Nobcha/R909-SDR/R909-DSP_front.jpg

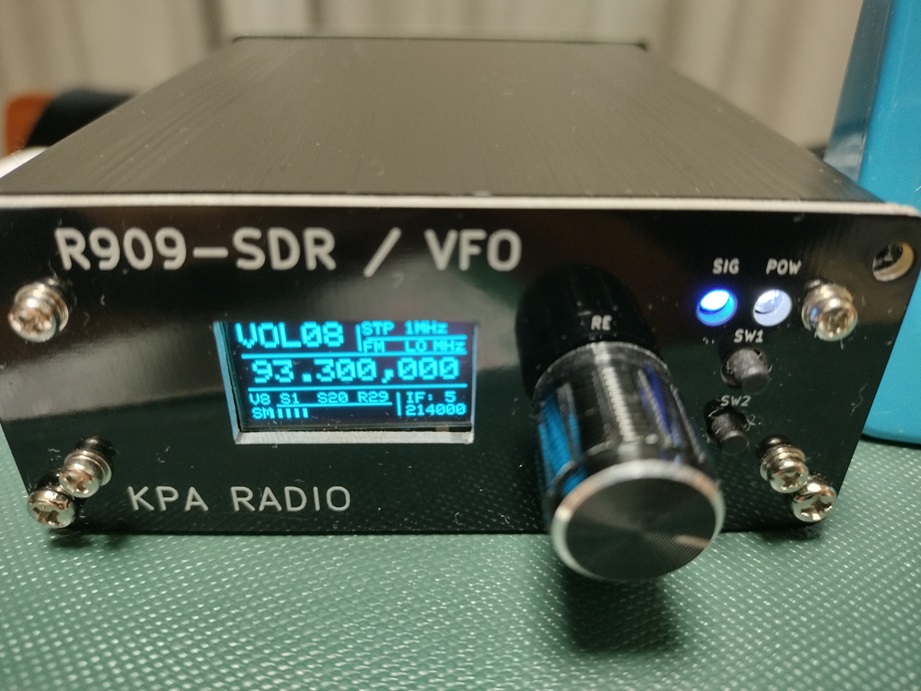
R909-DSP_front.jpg
