Nobcha/R909-SDR/dsp1_vs_dsp4_1.jpg

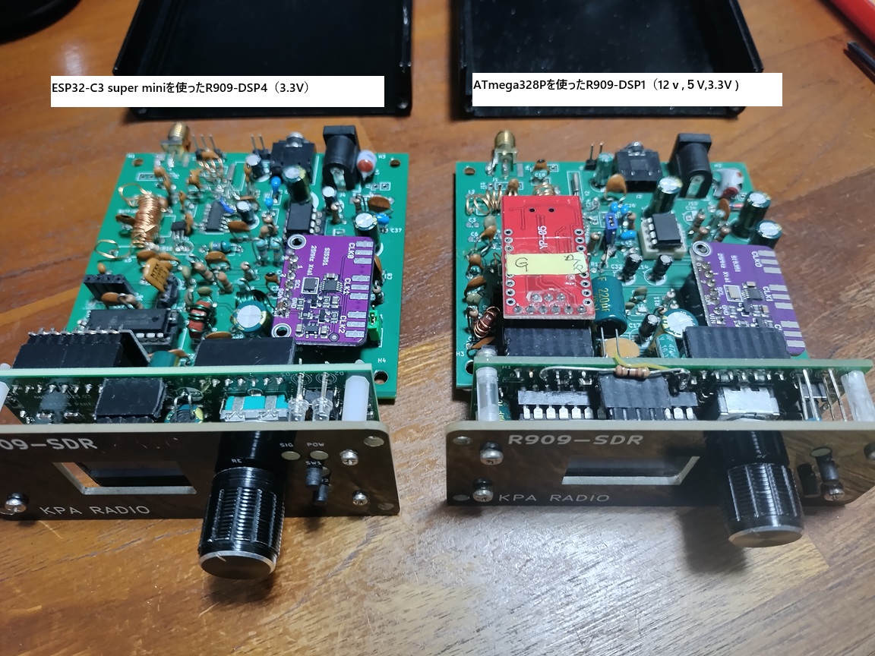
dsp1_vs_dsp4_1.jpg
