Nobcha/R909-SDR/R909_20240408JA_情報一覧.docx

R909-SDR current data warehouse 2023.12.27/2024.01.14/2024.01.17 | | | 2024.04.08
WEB DIRECTRY: https://github.com/Nobcha/R909-SDR/
プリントパターン、部品、スケッチなどの間違い訂正表 | | errata: errata1221.jpg
R909-DSP-1602 | Data 2023.12.27 | WEB Address | 注記
RF PCB RF部基板関連 | Gerber | 4732_2003_386_W78.kicad_pcb-1.zip | VIA抜けあり
| Block diagram | R909-SDR-1602_BD.jpg | ブロック図
| BOM | 4732_2003_386_BOM.pdf | 部品構成表
| Coils | coils_R909-SDR.pdf | コイル巻き方
| SILK | 4732_2003_386_RF_silk.pdf | SILK
| Schematic | 4732_2003_386_RF_scm.pdf. | 回路図
Debug Panel PCB LCD1602Aを使ったパネル部基板関連 | Gerber data | 5531_debugPanel.zip | Gerber (http://chitose6thplant.web.fc2.com/R909/5531_debugPanel.zip)データ
| Block diagram | R909-SDR-1602_BD.jpg | ブロック図
| PCB A side | 5351_pro_at_LCD_A.pdf | A side
| PCB B side | 5351_pro_at_LCD_B.pdf | B side
| BOM | 5531_debug_panel_bom.pdf | 部品表
| PCB silk | 5351_pro_at_LCD_SILK.pdf | SILK (http://chitose6thplant.web.fc2.com/R909/5351_pro_at_LCD_SILK.pdf)
| schematic | 5531_debug_panel_scm.pdf | 回路図
1602Ａ表示 | Arduino sketch | R909-SDR-1602_test4.ino | Arduino code
操作法に関するデータ | Operation flow chart | R909_op_flow.jpg | 操作処理の流れ
| Operation example video | https://www.youtube.com/watch?v=wb-YdMU-vz0 | YOUTUBE
R９０９-DSP－OLED | Data_NAME@2023.12.27/2024.01.14 | WEB Address | 注記
RF PCB RF部基板関連 | Gerber | 4732_2003_386_W78.kicad_pcb-1.zip | VIA抜けあり
| Block diagram | R909-SDR-1602_BD.jpg | ブロック図
| BOM | 4732_2003_386_BOM.pdf | 部品構成表
| Coils information | coils_R909-SDR.pdf | コイルの作成
| PCB silk | 4732_2003_386_RF_silk.pdf | SILK
| schematic | 4732_2003_386_RF_scm.pdf | 回路図
Panel PCB OLEDを使ったパネル部基板関連 | Gerber | 5531_ATm_20_NORM.kicad_pcb-2 | 基板発注用
| Block diagram | R909-SDR-OLED_BD.jpg | ブロック図
| BOM | R909-SDR-Panel_OLED_bom.pdf | 部品構成表
| PCB silk | panel20_PCB_silk.jpg | SILK
| schematic | R909-SDR-Panel_OLED_scm.pdf | 回路図
ＯＬＥＤ表示のＡｒｄｕｉｎｏスケッチ | R909-SDR-OLED_test2 | R909-SDR-OLED_test2.ino | 20240206版
最新Ａｒｄｕｉｎｏスケッチ | R909-SDR-OLED_test3 | R909-SDR-OLED_test3.ino | 20240210版
操作の仕方 | Operation flow chart | R909-SDR-OLED_flow.jpg | 操作の流れ
| R909-SDR | https://www.youtube.com/watch?v=UpdDh7BYJYI | YOUTUBE
操作法解説 | The air band receiver of R909-SDR-OLED version | https://www.youtube.com/shorts/03Hpvuk5BYI | YOUTUBE
診断スケッチなど | Sketch name | Sketch stored address | 注記
i2c アドレス調べ | i2c_scanner_R909PANEL.ino | i2c_scanner_R909PANEL.zip | ＵＳＢシリアル
Si4732コマンド | SI4735_01_POC_5351.ino | SI4735_01_POC_5351.ino | ＵＳＢシリアル
組立、操作の説明 | R909-DSP 受信機マニュアル | https://github.com/Nobcha/R909-SDR/R909-SDR_manual02_JA.pdf | 作成途中
