Nobcha/R909-SDR/coils_R909-SDR.pdf

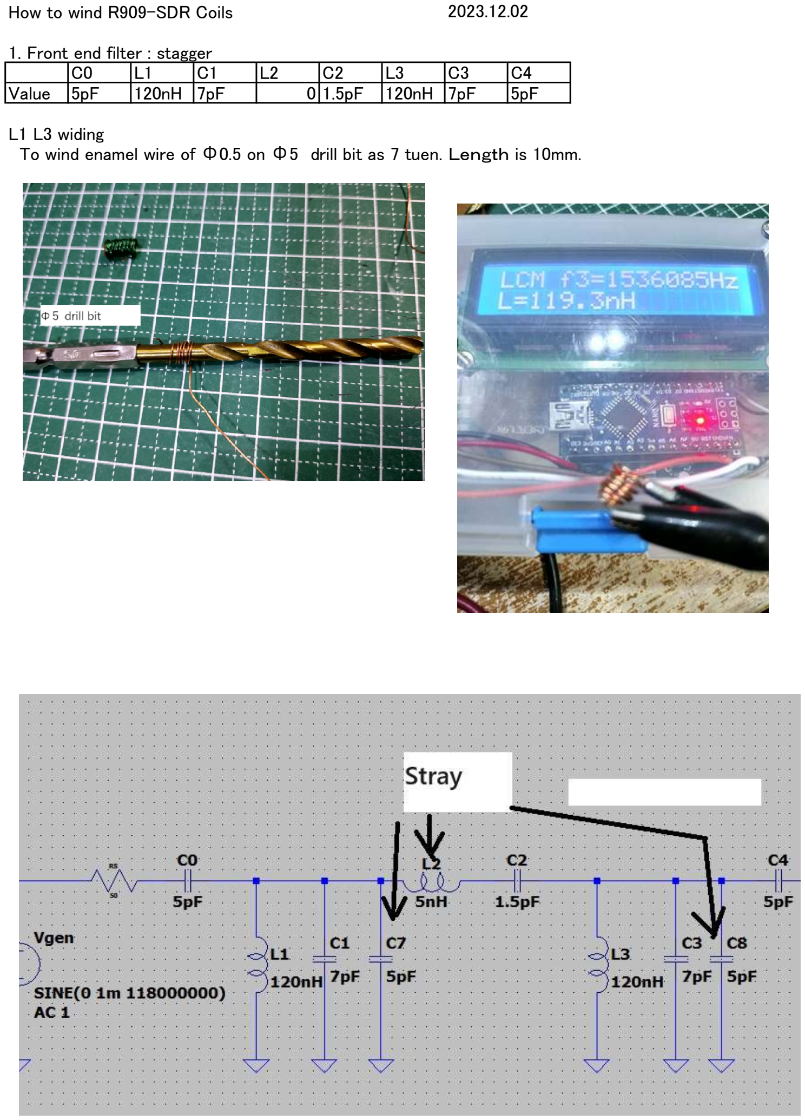
[picture p3: page 1]

How to wind R909-SDR Coils

### 1. Front end filter : stagger

| C0 | L1 | C1 | L2 | C2 | L3 | C3 | C4
Value | 5pF | 120nH | 7pF | 0 | 1.5pF | 120nH | 7pF | 5pF

L1 L3 widing
To wind enamel wire of Φ0.5 on Φ5　drill bit as 7 tuen. Ｌｅｎｇｔｈ is 10mm.

2023.12.02

The actual band path characteristics to monitor by nano VNA. Cener 120MHz ±5MHｚ　-10ｄＢ

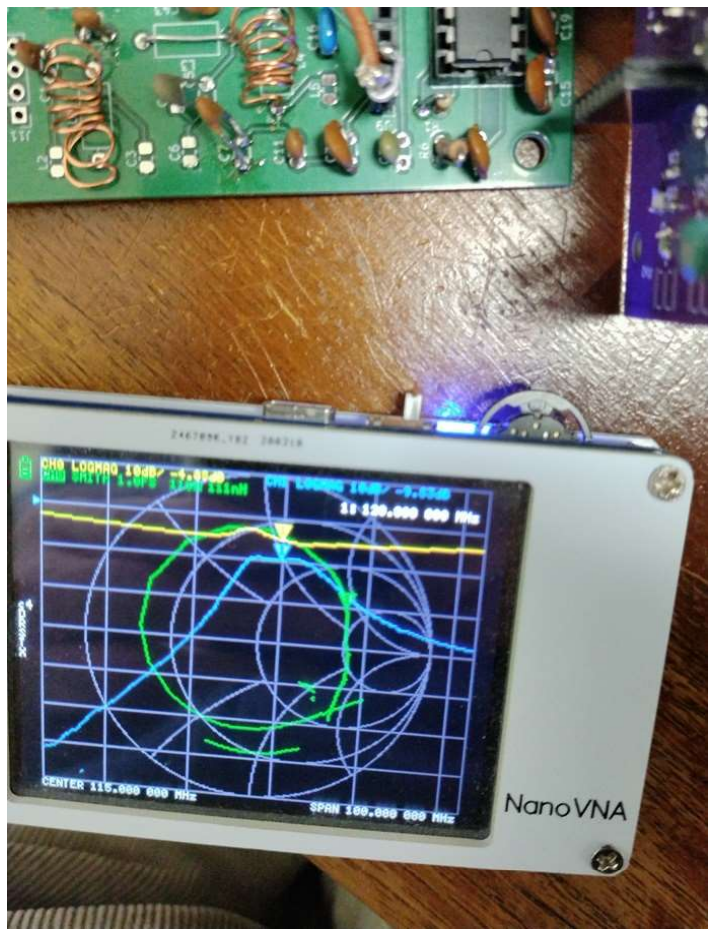
[picture p4: figure]

### 2. TA2003 FM-RF-OUT coil （To be replaced with R1）

Troidal core T25-2(Red) ０.５Φ　Enamel wire 8 turns

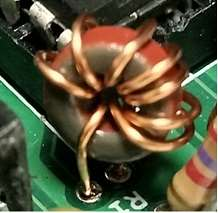
[picture p5: figure]
