Nobcha/R909-SDR/ATmega_ESP32-C3.jpg

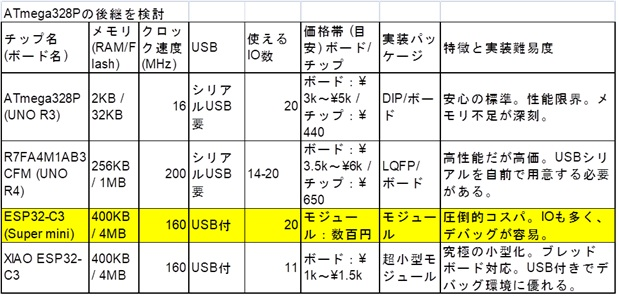
ATmega_ESP32-C3.jpg
