Nobcha/R909-SDR/dsp1_vs_dsp4_4.jpg

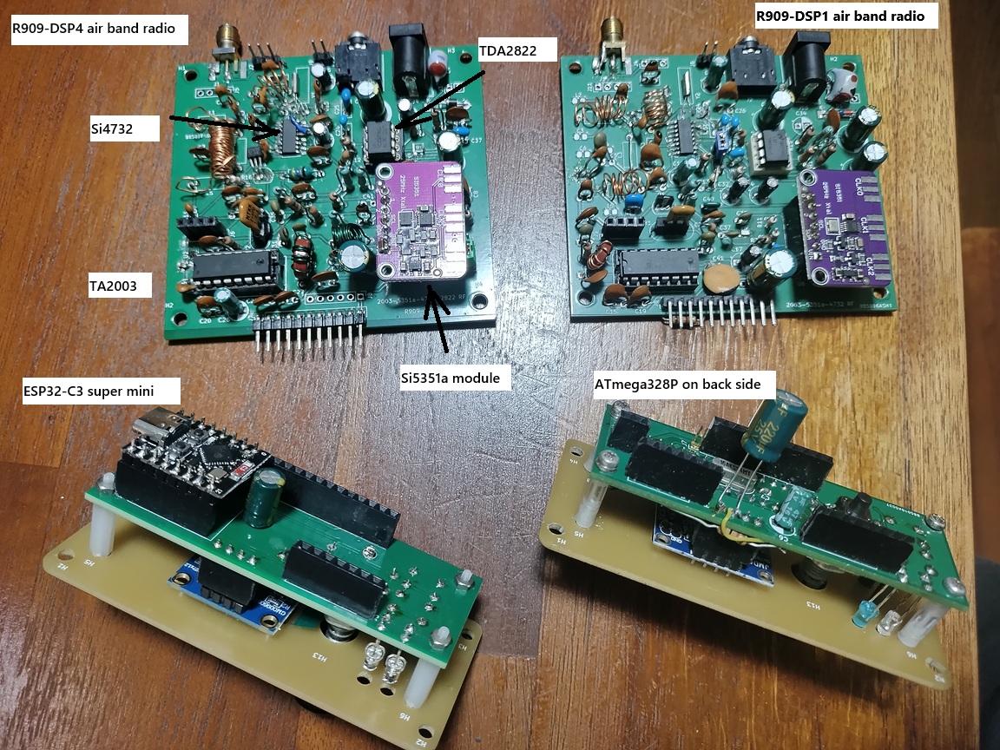
dsp1_vs_dsp4_4.jpg
