Nobcha/R909-SDR/panel20_PCB_silk.jpg

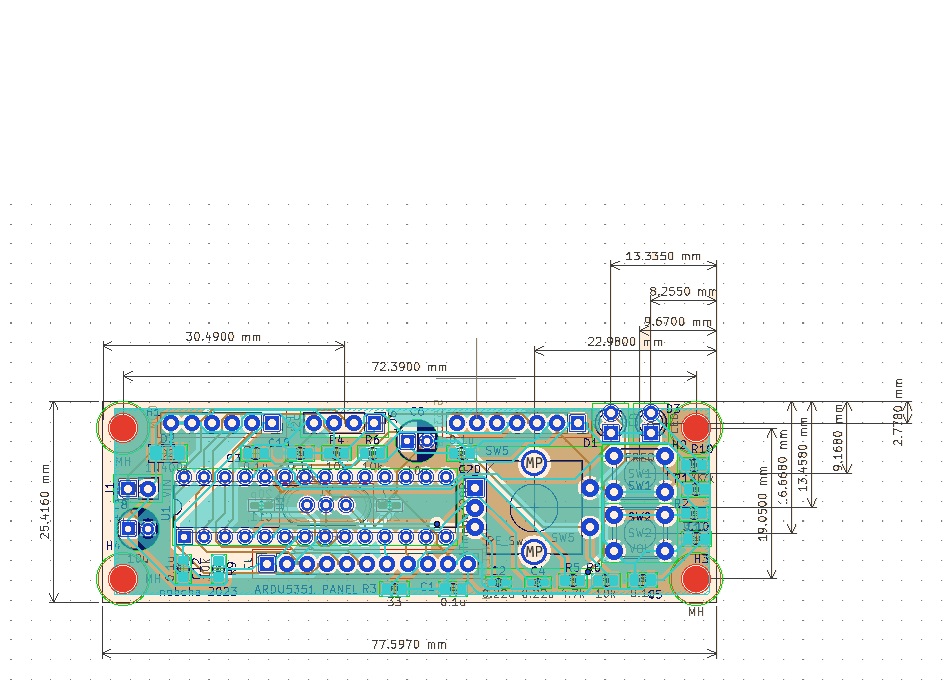
panel20_PCB_silk.jpg
