Nobcha/R909-SDR/r909-DSP_back.jpg

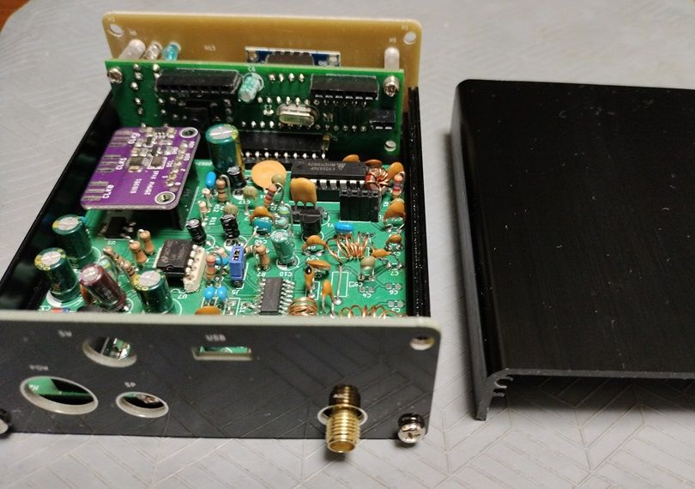
r909-DSP_back.jpg
