Nobcha/R909-SDR/r909-DSP_list_1.jpg

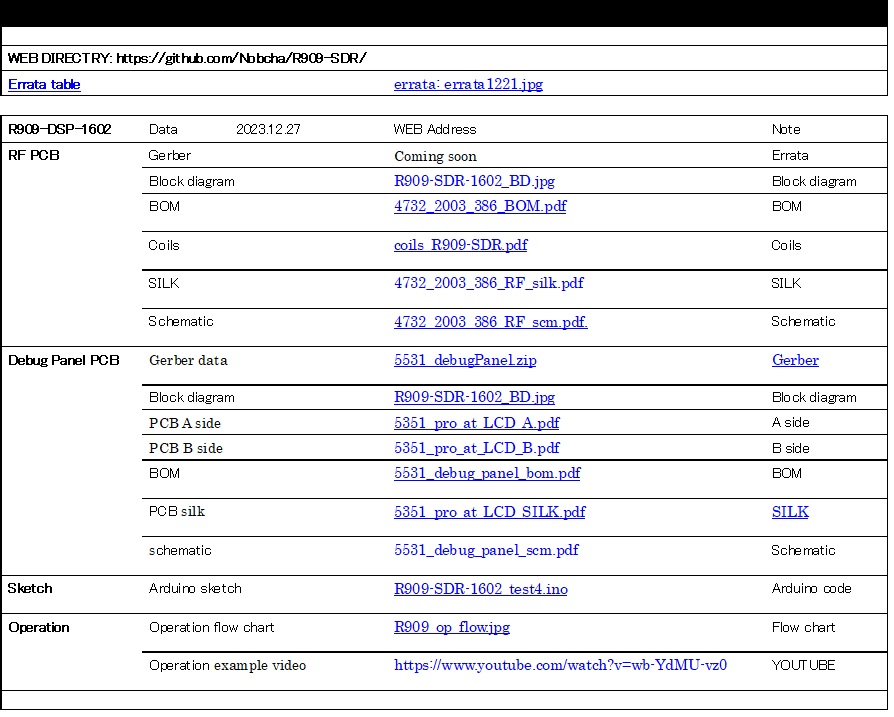
r909-DSP_list_1.jpg
