Nobcha/R909-SDR/r909-DSP_list_2.jpg

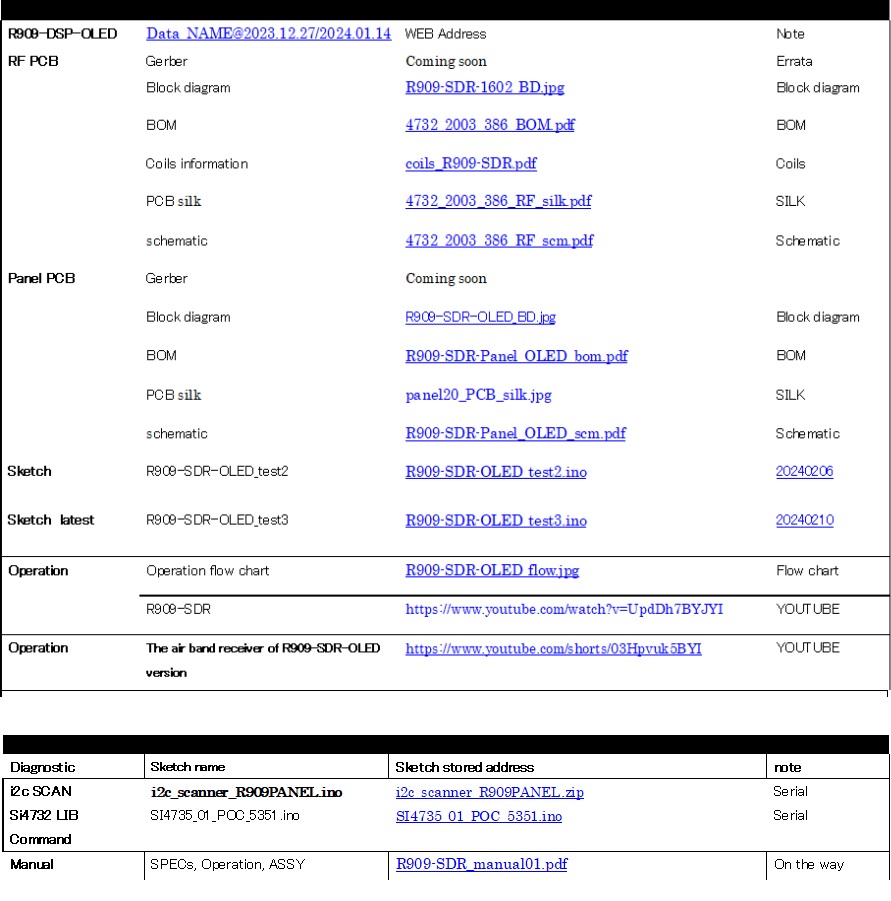
r909-DSP_list_2.jpg
