Nobcha/R909-SDR/R909-SDR-1602_BD.jpg

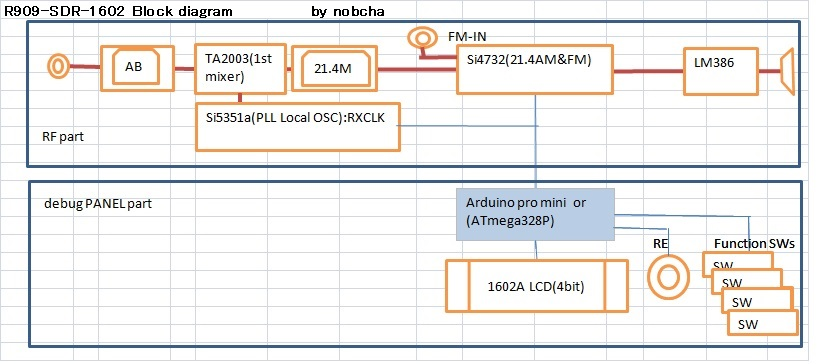
R909-SDR-1602_BD.jpg
