Nobcha/R909-SDR/R909-SDR-OLED_BD.jpg

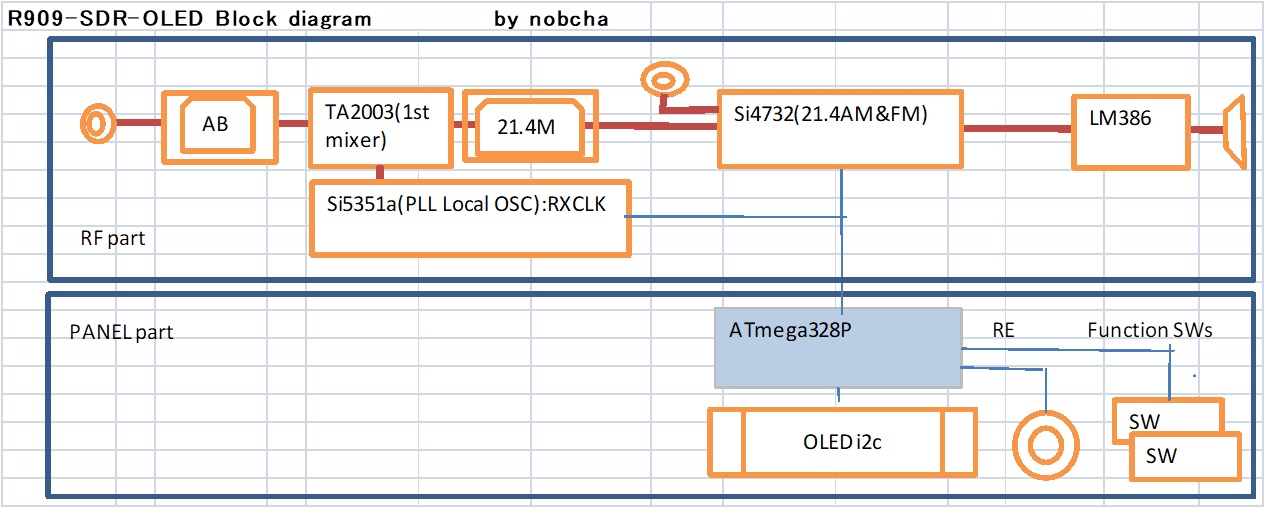
R909-SDR-OLED_BD.jpg
