Nobcha/R909-SDR/R909-SDR-OLED_flow.jpg

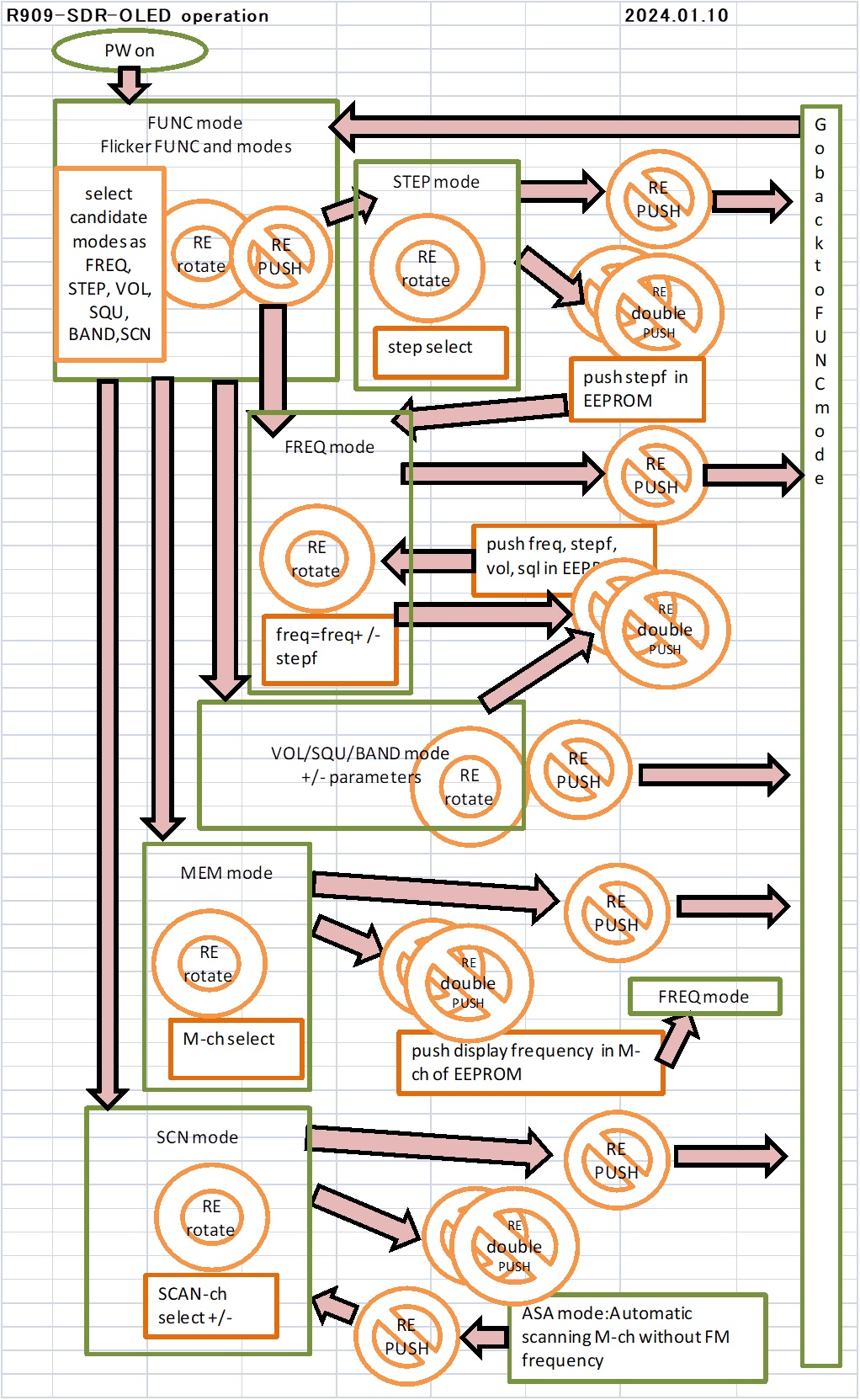
R909-SDR-OLED_flow.jpg
