Nobcha/R909-SDR/R909_op_flow.jpg

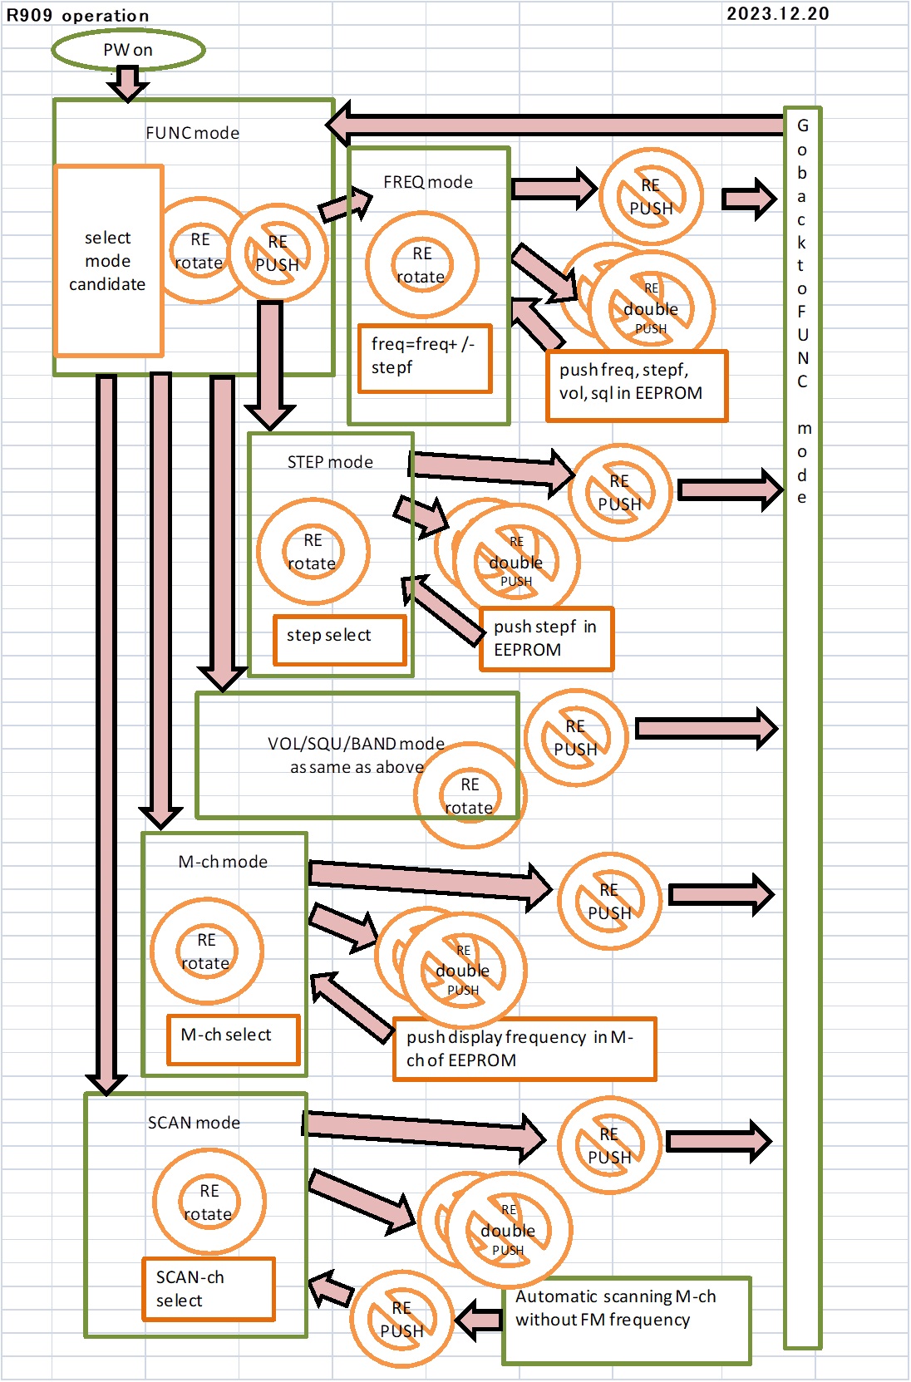
R909_op_flow.jpg
