Nobcha/R909-SDR/R909-SDR_manual02_JA.pdf

## R909-DSP 受信機 (Arduino+Si4732+Si5351a+TA2003+LM386)

## 2024.04.09 tentative by nobcha

### 1. 始めに


-受信機の外観

R909-4732(DSP) は航空無線受信と FM 放送受信ができます。Si5351a, Si4732, TA2003 などのＩＣが 使われています。TA2003とSi5351aをArduino制御し受信周波数を決め、Si4732は中間周波数21.4MHz の受信機として動作させています。ＦＭ放送受信は Si4732 の蓬莱機能を使っています。Arduino の Si4732 制御は PU2CLR のライブラリを利用しました。表示の違いで 2 種類の構成があり、一つは LCD2 行の 1602A を使ったもの、もう一つは OLED(128x64 ビット)を使ったものです。OLED 表示の画面デ ザインは JCR さんの 10khz-to-225mhz-vfo 画面を参考にしました。


-回路ブロック図

この受信機を操作するにはロータリーエンコーダとロータリーエンコーダに付いたプッシュスイッチを 主に使います。

回路基板は Panel 部（CPU、表示、スイッチなど）と RF 部（ラジオや局発モジュールやアンプなど） の二枚から構成されます。Panel 部基板は二種合って 1602A の LCD と OLED 表示のものです。


-受信機のケースの中

### 2. R909-DSP（4732）受信機の詳細

### 2.1 仕様

・受信帯域：航空無線帯域 AM; 118-136MHz, FM 放送帯域 FM: 76-109MHz ・感度：およそ -85dBm
・供給電源：DC+12V、およそ：110 mA
・音声出力：1W max, 2.5 jack
・ケースの大きさ：38h x 88w x 100d、重量：およそ 250grm

### 2.2 回路と基板

回路は RF 部基板と Panel 部基板から構成されます。RF 部には初段フィルター、ミキサーの TA2003、 局発の Si5351a モジュール、LM386 の音声アンプ、電源回路が含まれています。Panel 部には CPU の ATmega328P（Arduino ブートローダ付き、1602A 基板の場合は Arduino pro mini も使えるようになっ

ている)と表示モジュール、スイッチが搭載されています。回路図は次に示す通りです。 Panel 部回路図（1602A）：https://github.com/Nobcha/R909-SDR/5531_debug_panel_scm.pdf Panel 部回路図（OLED）：https://github.com/Nobcha/R909-SDR/R909-SDR-Panel_OLED_scm.pdf RF 部回路図：https://github.com/Nobcha/R909-SDR/4732_2003_386_RF_scm.pdf

### 2.3 操作について

機能操作はロータリーエンコーダとロータリーエンコーダについたプッシュスイッチで行う。3 つの操作 モードがある。機能（FUNC）を選択するモード、各機能の中でパラメータの増減、そして、現状デー タの EEPROM へ記憶させるモードである。機能名称と FUNC が交互表示しているときはロータリーエ ンコーダを回すと機能次々と選択される。プッシュキーを押すと今点滅表示されている機能を選択する。 そうなるとロータリーエンコーダはパラメータの増減に使われる。プッシュキーを一回押すと設定パラ メータを確定し、機能選択モードに戻り、機能名称と FUNC が交互表示される。一回押しでなく二回押 し（ダブルクリック）だと、パラメータを EEPROM に書き込んで元に戻る。操作の流れについては下 記のスローチャート図に示した。
機能は次の 10 種類が用意されている。
・Func: 各機能を選択するモードである。
・FRQ: 周波数を設定するモードで、STP で指定されたステップ周波数単位でインクレメント、デクレ メントする。
・STP: ステップ周波数単位を次から選択。10Hz, 1kHz, 10kHz, 100kHz, 1MHz, and 25kHz ・MEM: 表示されている周波数を記憶するメモリー番号（50 種）を選ぶ。
・SCN: 周波数記憶したメモリー番号（50 種）を選び、呼び出し
・VOL: ボリュームの値を選ぶ
・SQU: スケルチの値を選ぶ
・BAND: AM モードか FM モードを選ぶ
・BAND_W: Si4732 の受信帯域を次から選ぶ 1Hz, 1.5kHz, 2kHz, 4kHz, and 6kHz ・F_COR: Si5351a の基本発振周波数 25MHz を精度補正値を設定


-操作の流れ


・OLED 表示の場合の表示項目説明
-Youtube video

### 2.4 スケッチについて

スケッチにはいくつかの汎用ライブラリや個別ライブラリ、また事例スケッチを引用させていただきま した。1602A 版と OLED 版の二種類のスケッチがあります。
ATmega328P には Arduino UNO のブートローダを書き込んで使っています。
1602A 版 https://github.com/Nobcha/R909-SDR/
OLED 版 https://github.com/Nobcha/R909-SDR/R909-SDR-OLED_test3.ino

There are the diagnostic sketches for testing the hardware, as i2c scanner and USB serial controlling Si4732.
https://github.com/Nobcha/R909-SDR/i2c_scanner_R909PANEL.ziphttps://github.com/Nobcha/R909-SDR/SI4735_01_POC_5351.ino

### 3. 基板の組み立て方

### 3.1 Panel 部 PCB

1602A 版 PCB では Arduino をどちらにするかで部品構成が変わります。

CRD 部品は表面実装を使っていますので、まずはそれらから実装してください。その後背の低い DIP 部 品を実装します。部品は A 面だけでなく B 面にも実装しますのでご注意ください。

https://github.com/Nobcha/R909-SDR/R909-SDR-Panel_OLED_bom.pdfhttps://github.com/Nobcha/R909-SDR/5531_debug_panel_bom.pdf

Arduino や ATmega328P はソケットを使用します。OLED,LED,SW,ロータリーエンコーダはフロント につける意匠パネルとの位置関係があるので注意して取り付けて下さい。 基板への部品実装がうまくいったかどうかは i2c アドレススキャンプログラムを用いて確認ができます。 OLED のアドレス 0x3c が結果表示されるなら組立は成功です。


・部品はんだ付け後調整中

### 3.2 RF 部 PCB

まずは部品リストに従い、部品を用意します。使い方で要否判定しないといけない部品があるのでよく 注意してください。
https://github.com/Nobcha/R909-SDR/R909-SDR-Panel_OLED_bom.pdf

部品実装を手掛ける前にコイルの用意が必要です。ドリルビットなどを利用し、エナメル線で空芯コイ ルを巻きます。トロイダルコイルも必要です。
https://github.com/Nobcha/R909-SDR/coils_R909-SDR.pdf

こちらの基板もまずは表面実装部品を取り付けます。Si4732 などの IC は周りに何もない第一歩にはん だ付けします。


表面部品実装後、背の低い部品から DIP 部品やピンヘッダコネクタをはんだ付けします。

組立がうまくいったかは、Panel 部 PCB と同じく i2c アドレススキャンプログラムを用いて確認ができ ます。Si4732 のアドレス 0x11 や Si5351a のアドレス 0x60 が結果表示されるなら組立は成功です。

### 3.3 調整

コイルのパラメータ確認や、初段帯域フィルタの特性調整には nano VNA とか LC メーターがあると便 利です。.
また、動作確認には航空無線帯域内の微弱信号が用意できるとよいと思います。水晶発振器の高調波 (20MHz 台近辺の水晶なら 6 倍波ぐらいです)が使えます。空港の近辺なら、ATIS 受信が便利です。tiny SA ultra があれば、1ｄＢステップで変調信号付き該当周波数も簡単設定できる信号発生器が付いてい ますので、あると便利です。Y

### 3. 基板をケースに入れる

38x88x100 アルミダイキャストケースにＲＦ基板をスライド挿入し、前面アルミ板に Panel 基板を取り 付けます。
アルミ板加工が大変なので、替わりにプリント基板で全後面パネルを設計検討中です。

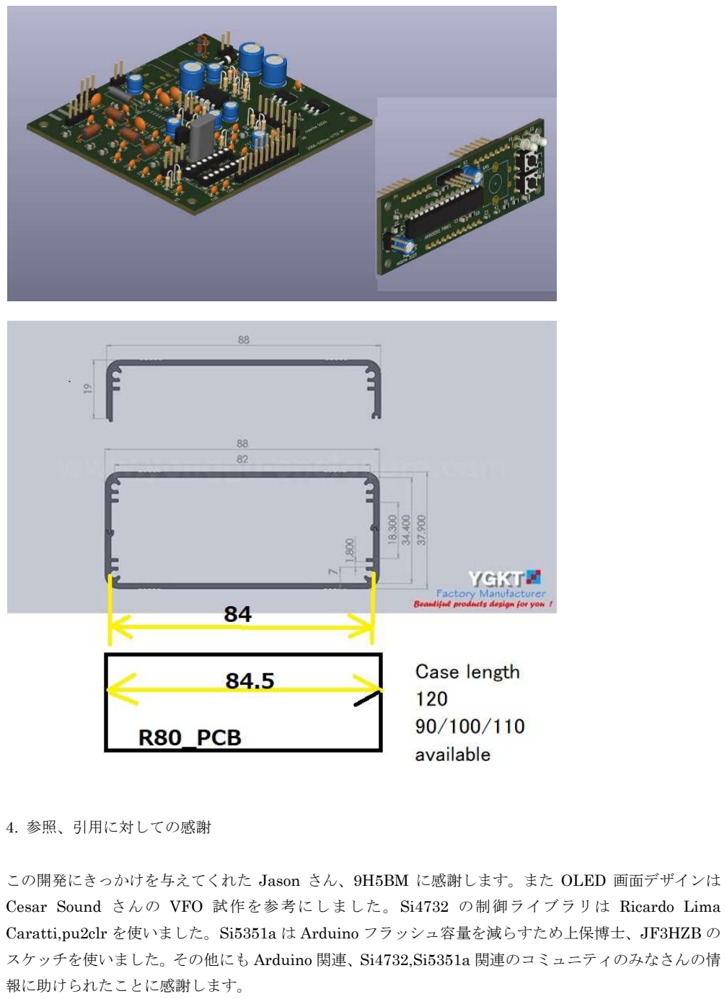
[picture p35: page 8]

### 4. 参照、引用に対しての感謝

この開発にきっかけを与えてくれた Jason さん、9H5BM に感謝します。また OLED 画面デザインは Cesar Sound さんの VFO 試作を参考にしました。Si4732 の制御ライブラリは Ricardo Lima Caratti,pu2clr を使いました。Si5351a は Arduino フラッシュ容量を減らすため上保博士、JF3HZB の スケッチを使いました。その他にも Arduino 関連、Si4732,Si5351a 関連のコミュニティのみなさんの情 報に助けられたことに感謝します。

Jason kits,9H5BM:https://www.facebook.com/profile.php?id=100012257914763
Ricardo Lima Caratti,pu2clr:https://github.com/pu2clr
上保 徹志 (Tetsuji Uebo),JF3HZB:https://tj-lab.org/2017/03/13/si5351/CesarSound:https://www.hackster.io/CesarSound/10khz-to-225mhz-vfo-rf-generator-with-si5351-ver sion-2-bfa619

©nobcha JA3KPA
