Nobcha/R909-SDR/errata1221.jpg

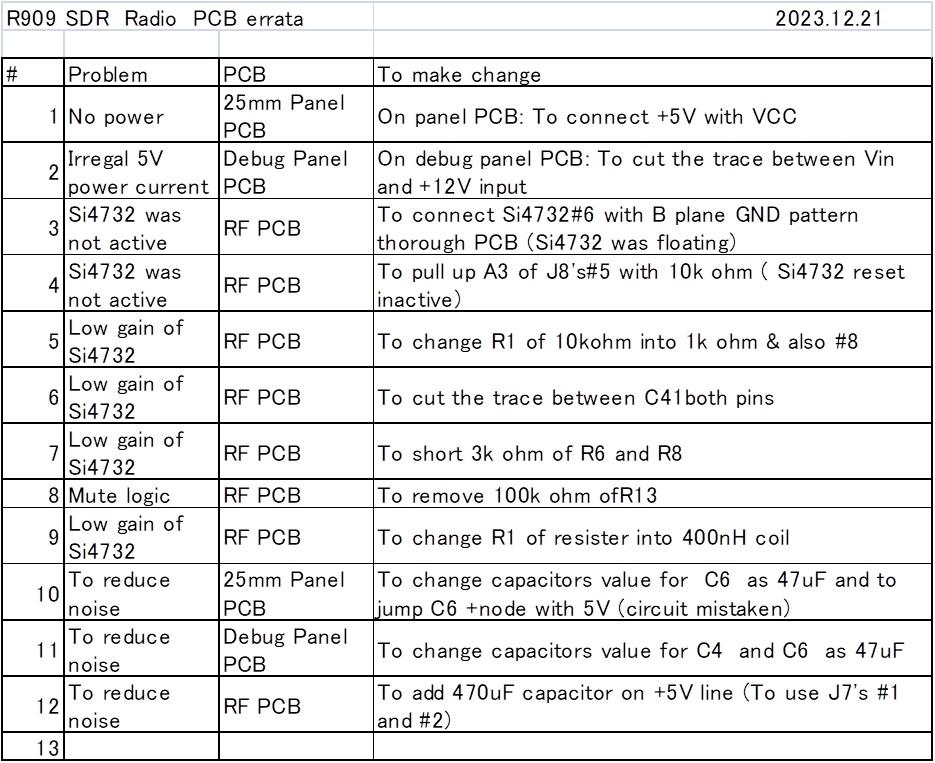
errata1221.jpg
