Nobcha/R909-SDR/errata240419.jpg

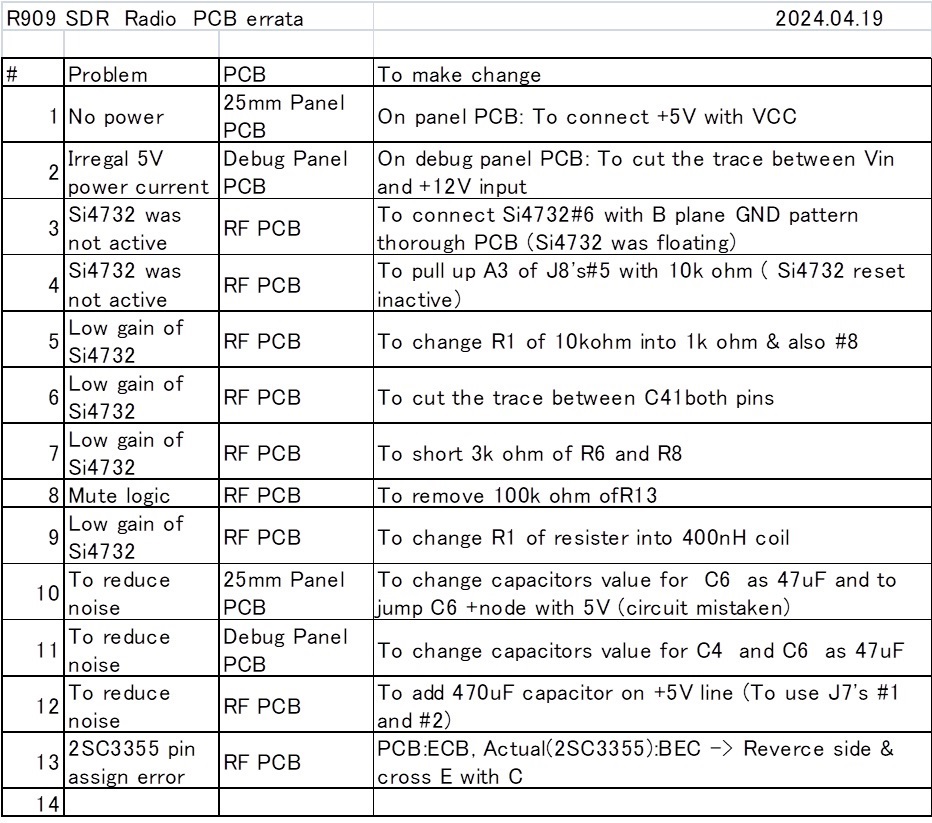
errata240419.jpg
