Nobcha/R909-SDR/errata240624.jpg

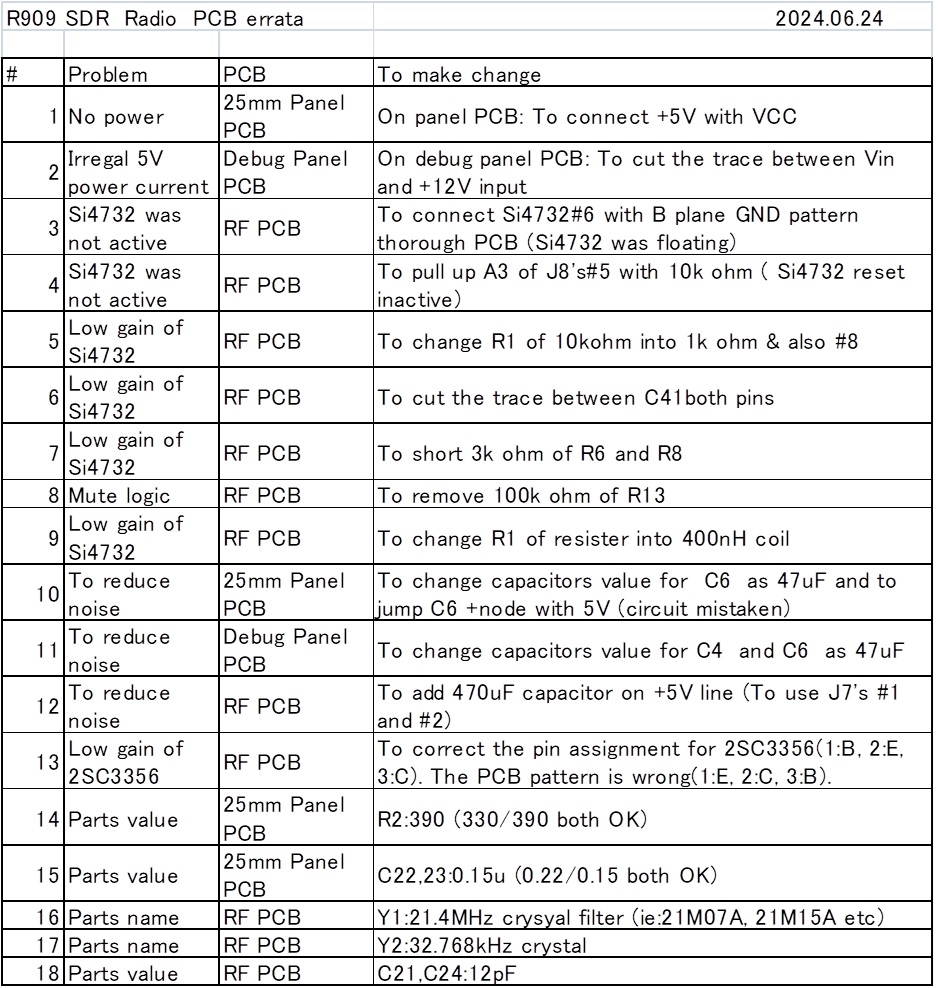
errata240624.jpg
