Nobcha/R909-SDR/5531_debug_panel_scm.pdf

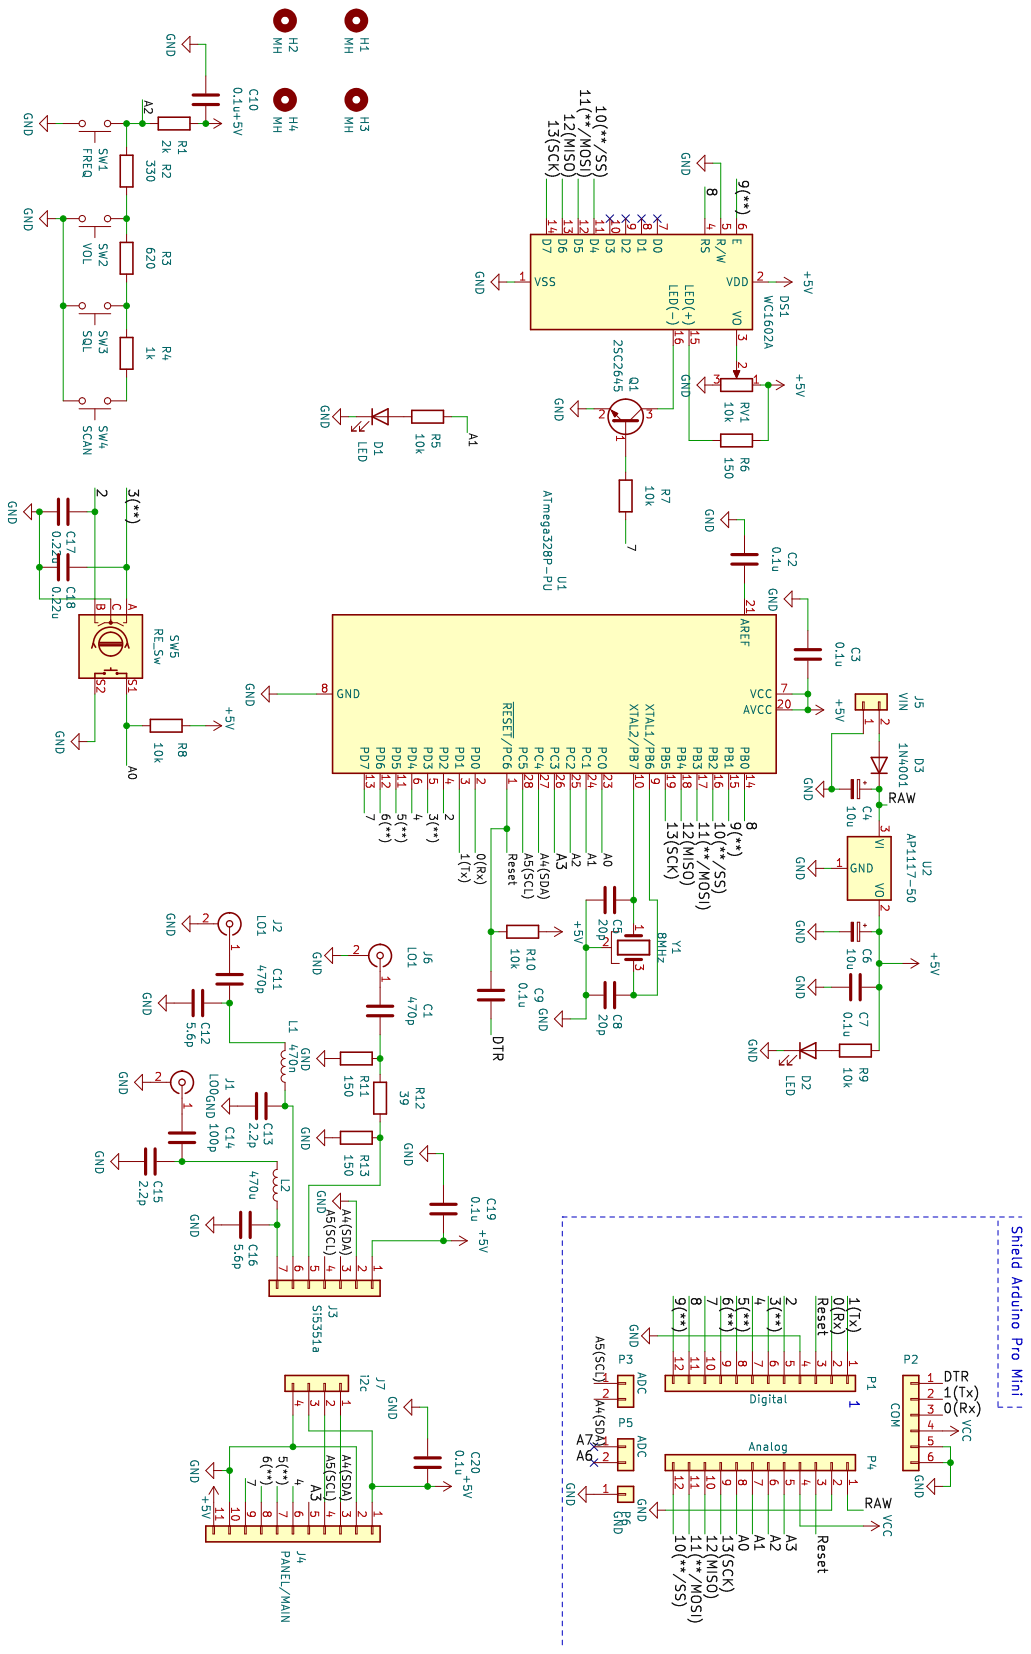
[picture p43: page 1]
