Nobcha/R909-SDR/R909-SDR-Panel_OLED_scm.pdf

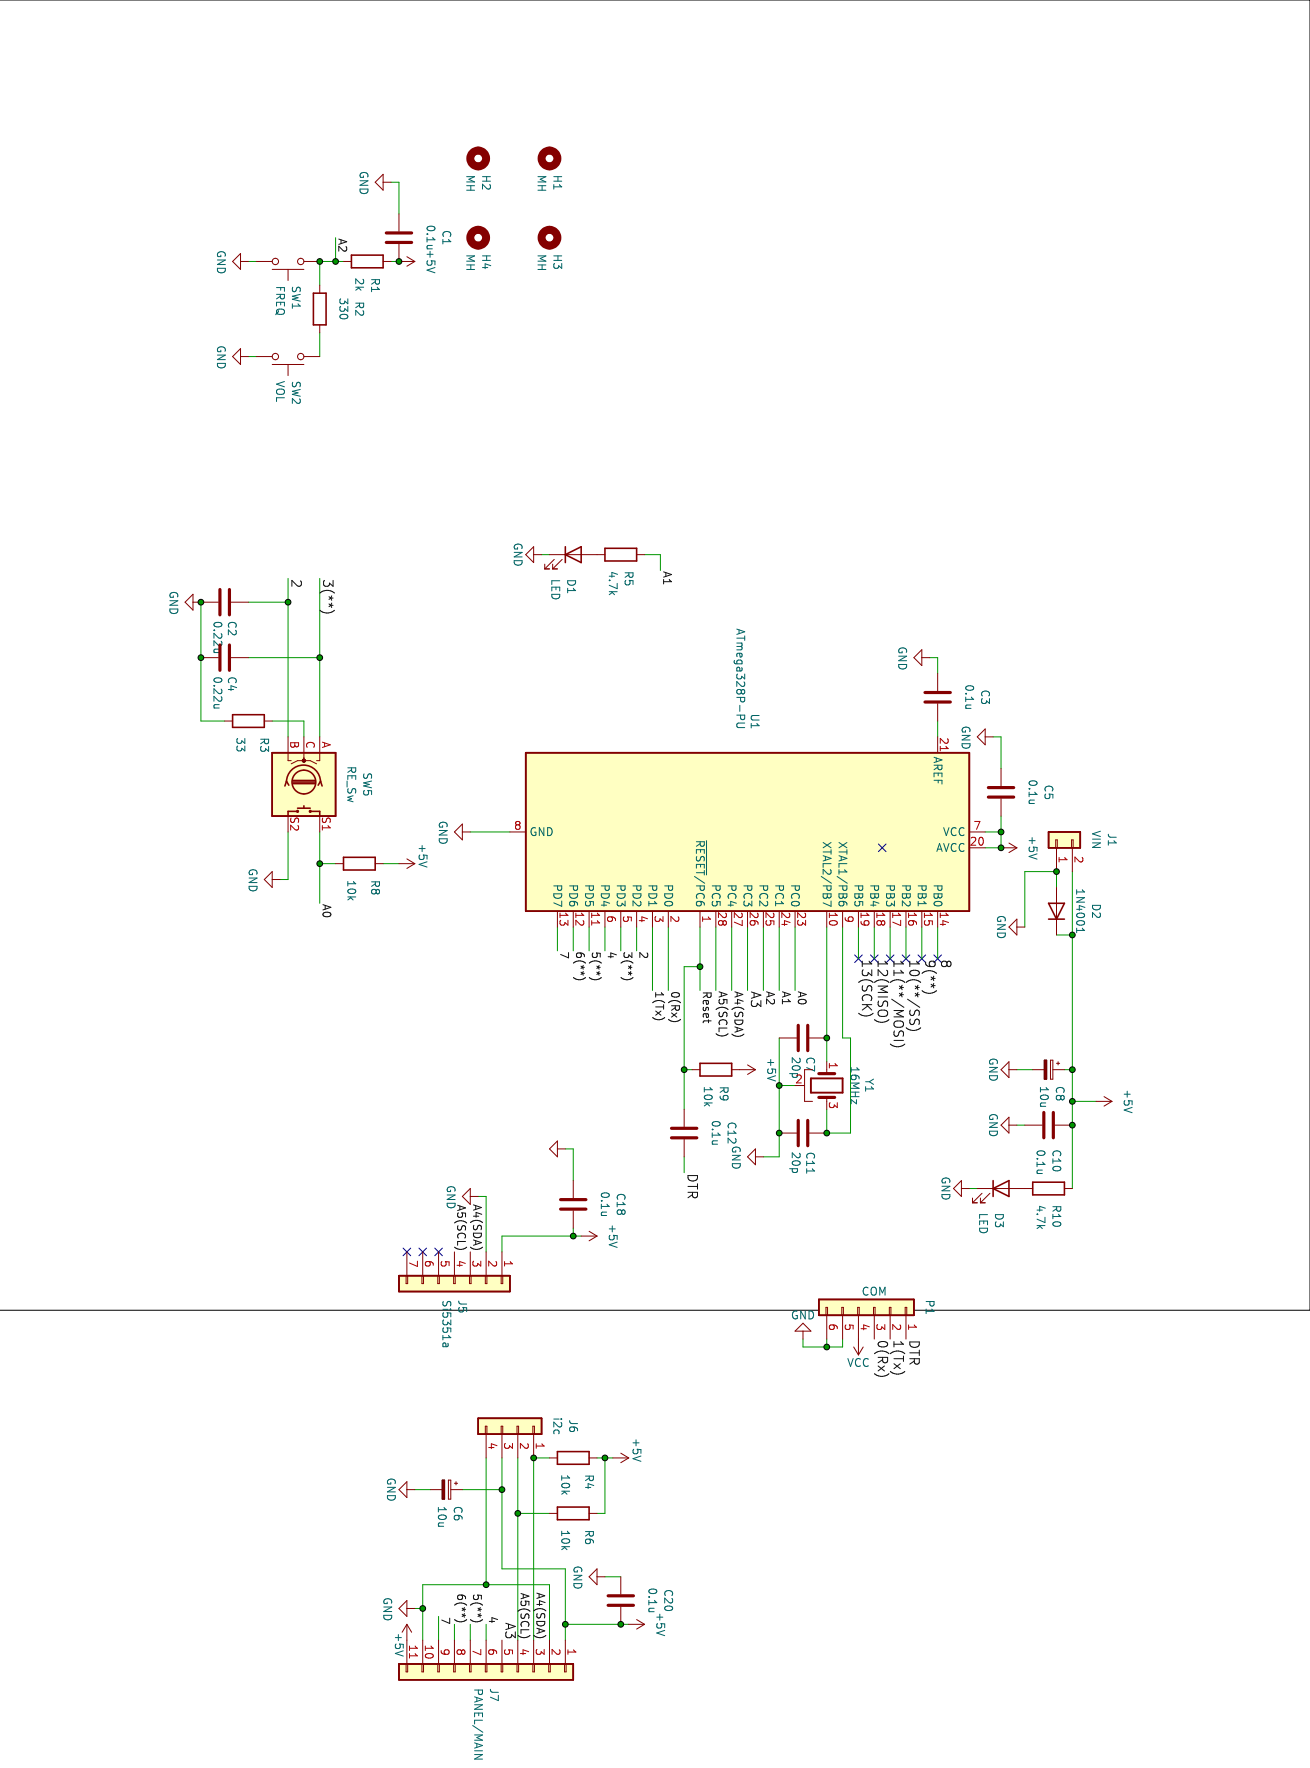
[picture p44: page 1]
