Nobcha/R909-SDR/RF_scm.pdf

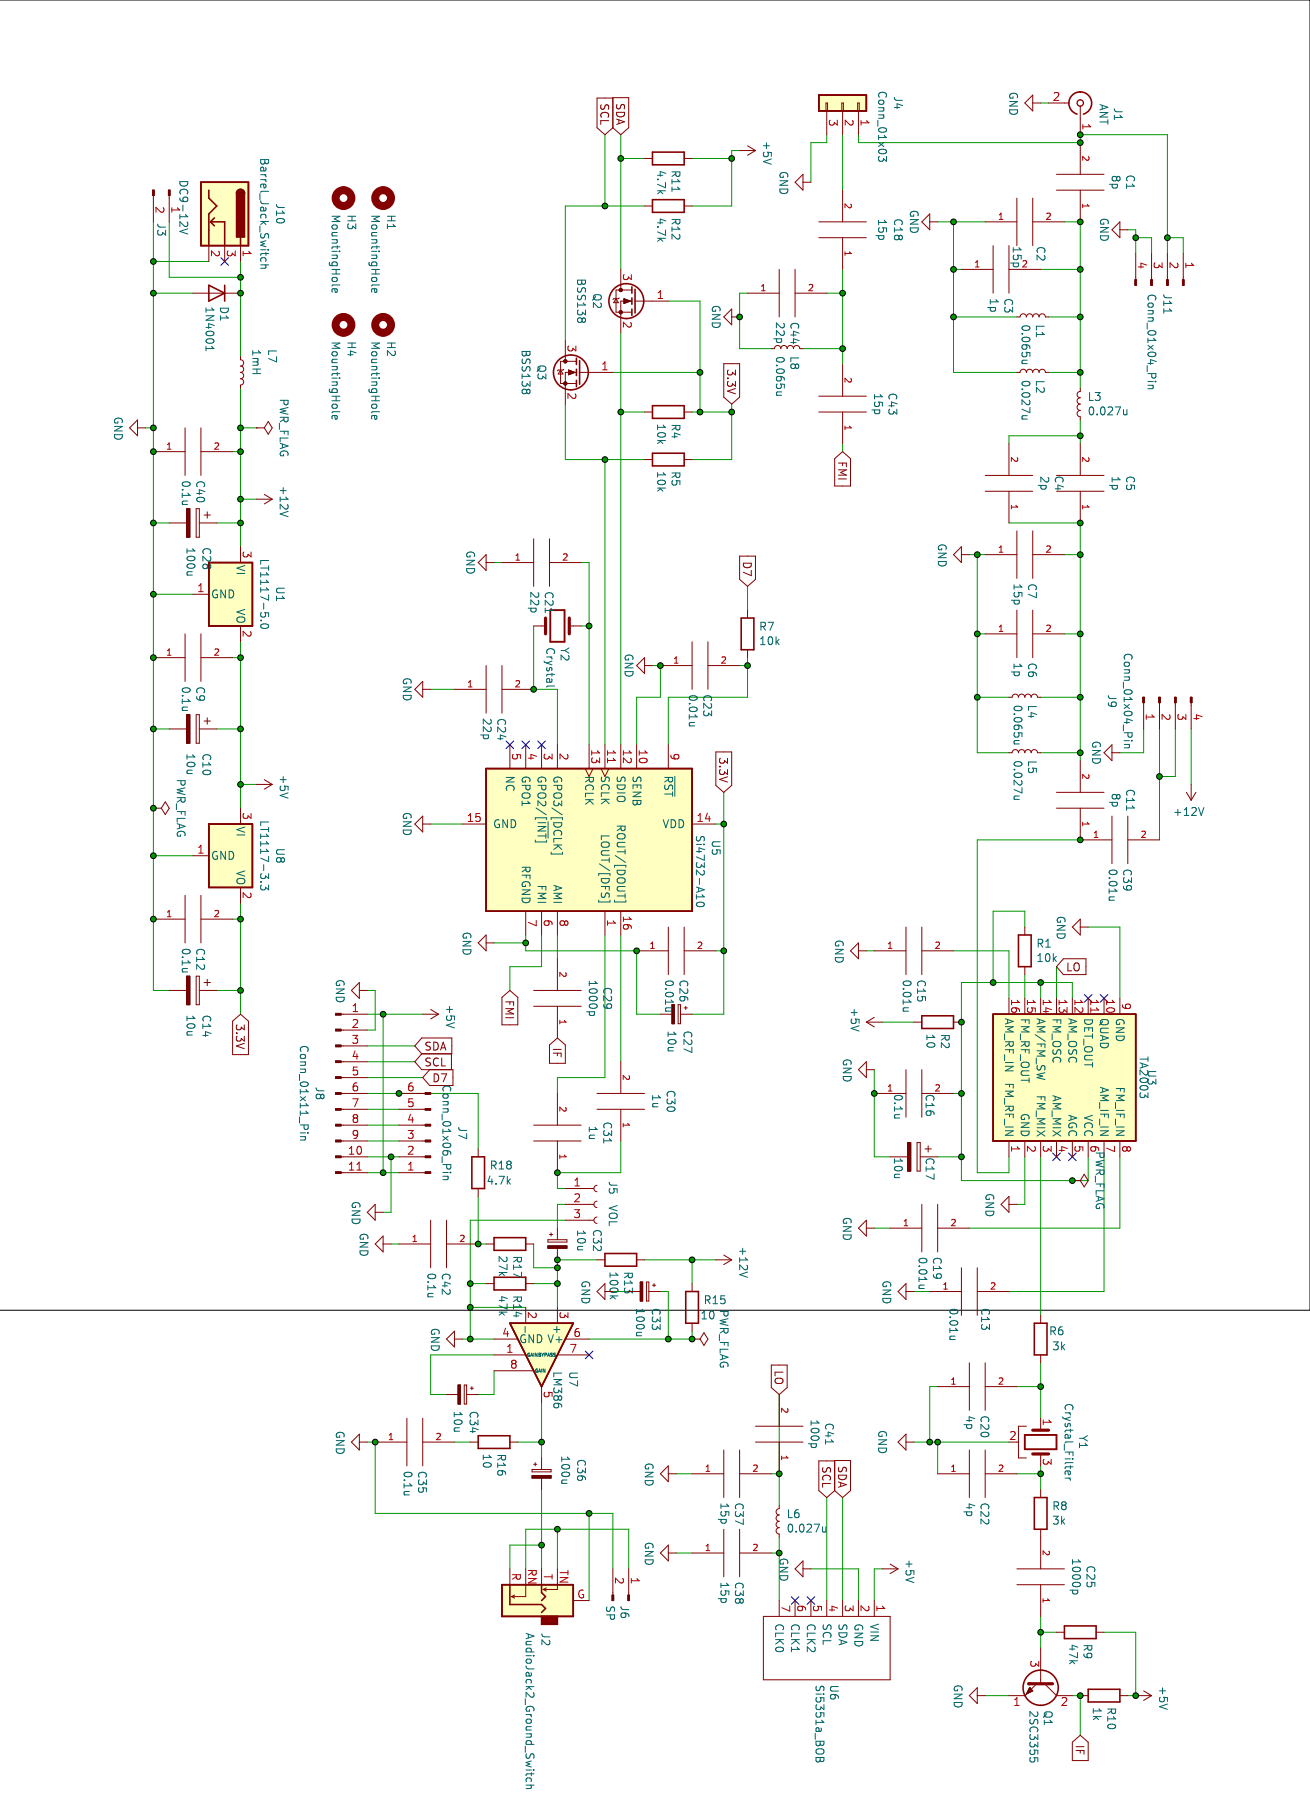
[picture p45: page 1]
