Nobcha/R909-SDR/5351_pro_at_LCD_SILK.pdf

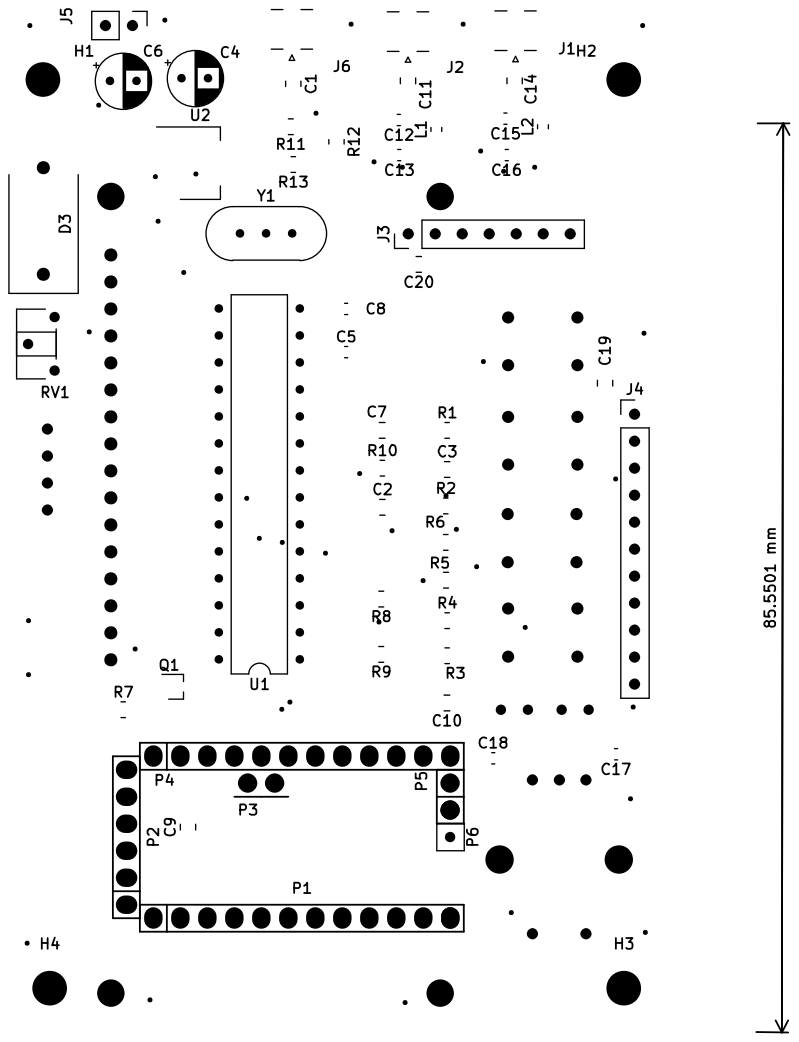
[picture p46: page 1]
