Nobcha/R909-SDR/5351_pro_at_LCD_B.pdf

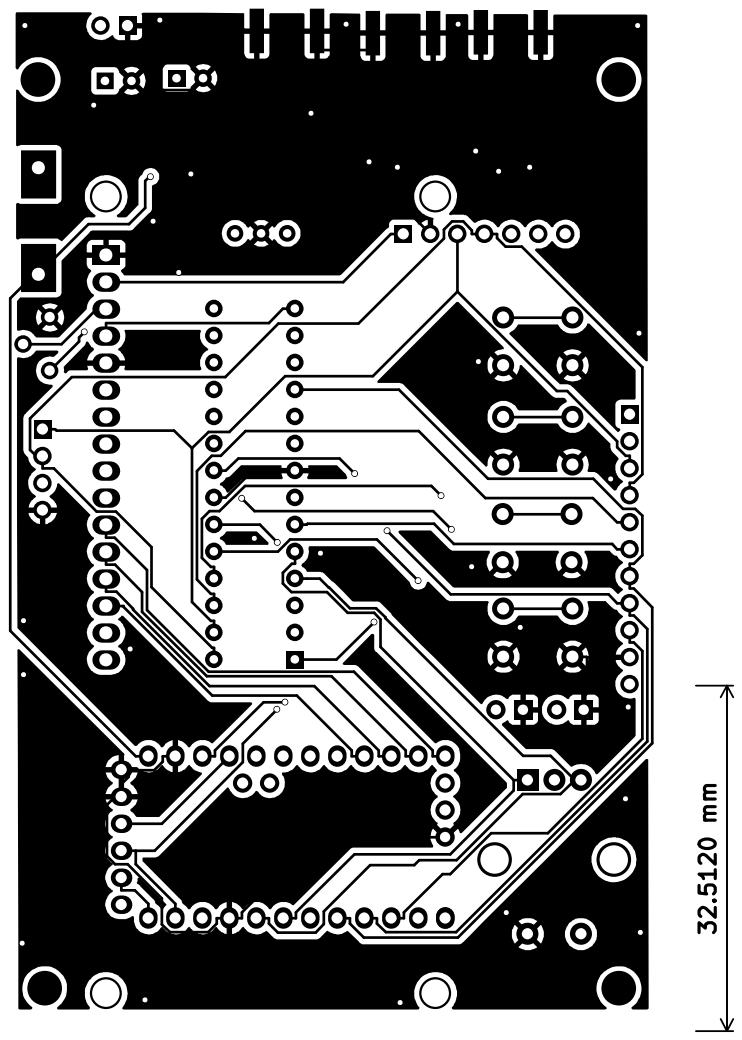
[picture p47: page 1]
