Nobcha/R909-SDR/5351_pro_at_LCD_A.pdf

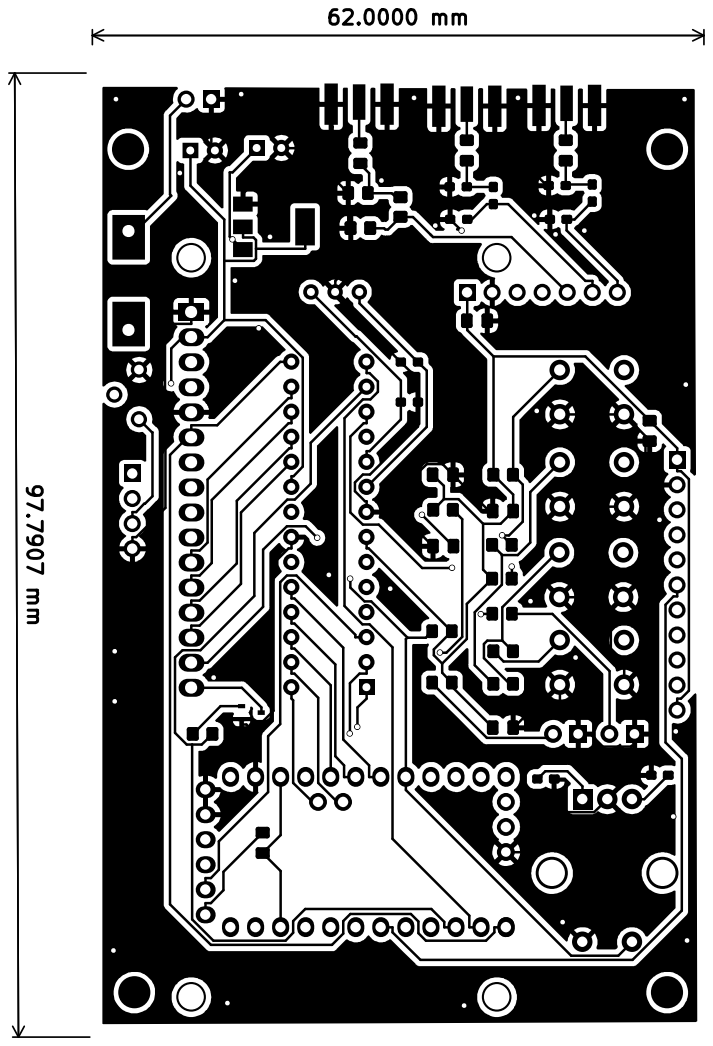
[picture p48: page 1]
