Nobcha/R909-SDR/4732_2003_386_RF_silk.pdf

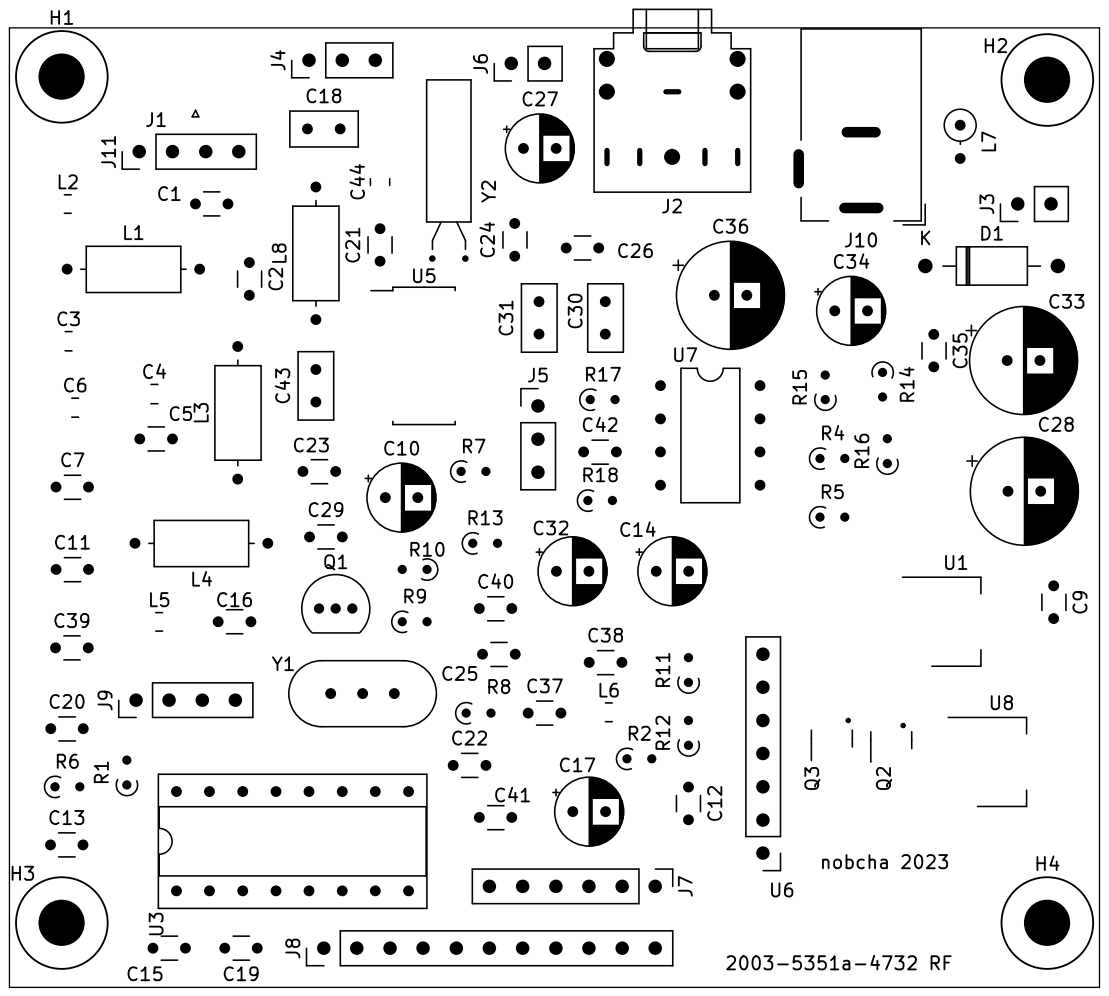
[picture p49: page 1]
