Nobcha/R909-SDR/(commit log)

2024-04-04 Case view
    The front and back panels are made of PCB.
2024-04-05 manual
    R909-DSP assembling and operating manual
2024-04-05 i2c scanner
    To test i2c connection
2024-04-05 eratta list currently
2024-04-05 RF PCB BOM
2024-04-05 RF PCB SILK
2024-04-05 Debug panel BOM
2024-04-05 Debug panel schematic
2024-04-05 Debug panel PCB gerber files
    For PCBGOGO
2024-04-05 Operation flow chart for 1602A type
2024-04-05 RF portion schematic
2024-04-05 Operation flow for OLED type
2024-04-05 Arduino sketch for R909-DSP_OLED_2
2024-04-05 Arduino sketch for OLED V3
2024-04-05 OLED panel BOM
2024-04-05 OLED panel schematic
2024-04-05 Resumed list 1/2
2024-04-05 Resumed list 2/2
2024-04-09 日本語表記のデータ説明一覧
    回路図、部品表、操作説明、基板ガーバー、Arduinoスケッチなどの情報一覧表です。
2024-04-09 日本語表記のマニュアル
    R909-DSP受信機の仕様、操作説明マニュアルです
2024-04-09 Gerber data
    PCB order data for PCBGOGO
2024-04-09 Panel data of Gerber
2024-04-09 Update README.md
    日本語表記データ説明などを追加
2024-04-19 Update README.md
    Please change pin connection for 2SC3355 because of PCB pattern error.
2024-05-28 Add files via upload
    i2c address scanner for R909-Panel at 3.3V supply
2025-07-02 The improved version for reducing the noises
    Changed the monitoring time slower for RSSI , and refresh display time.
    [R909-DSP3_test1.ino]
2025-10-05 To compare the R909-DSP1 with the R909-DSP4
    R909-DSP1 is combined with ATmega328P, TA2003, Si5351a, Si4732, and LM386. R909-DSP4 is combined with ESP32-C3 super mini, TA2003, Si5351a, Si4732, and TDA2822. R909-DSP4 can be operated by 3.9V Li+ battery. There are the list of comparison.
2026-08-04 Fix YouTube link and update PCB fabrication notes
    Corrected duplicate YouTube link for OLED panel and removed redundant text regarding PCB fabrication.
